letsfindaway/basement-ventilation/doc/feather.jpg

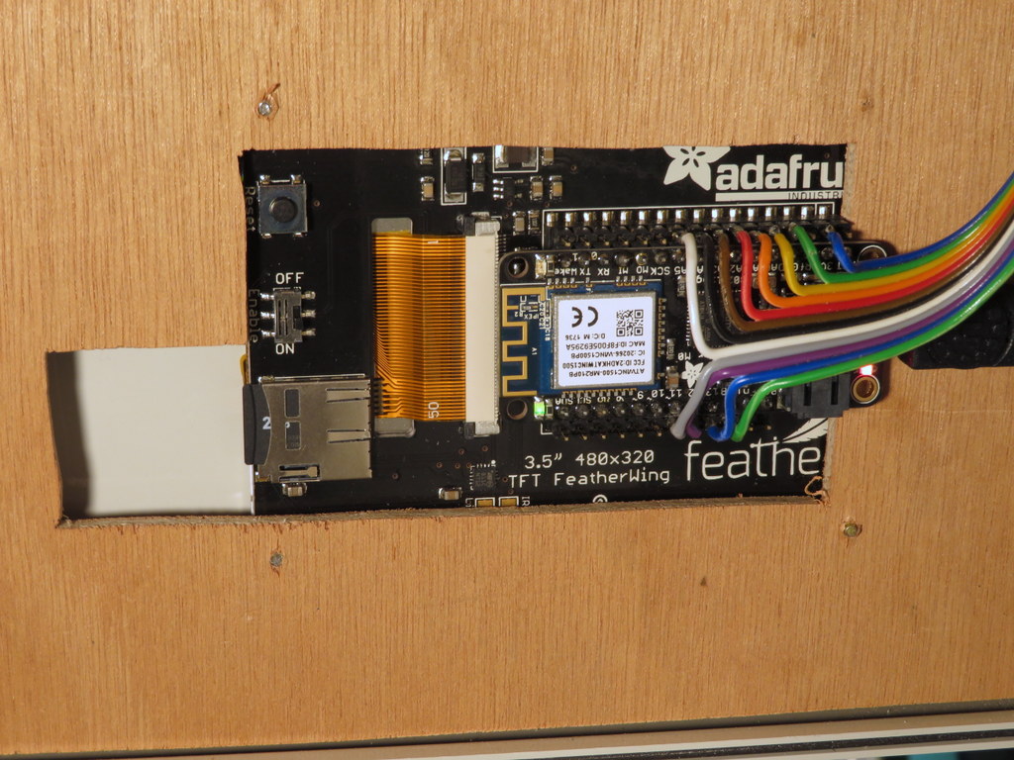
doc/feather.jpg
