letsfindaway/basement-ventilation/sdcard/Screen1.bmp

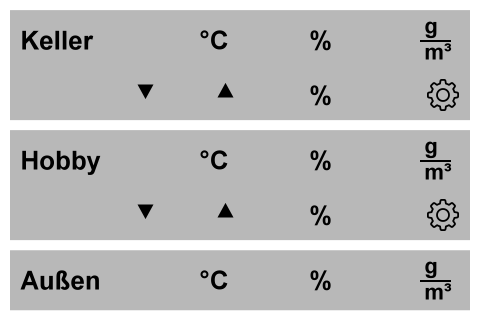
sdcard/Screen1.bmp
