letsfindaway/basement-ventilation/(threads)

Thread 2 (2018-01-24):

Switch display backlight off for power saving

letsfindaway, 2018-01-24:
Most probably the display backlight is the biggest power consumer of the system.

For power saving we might consider to switch the display backlight off after e.g. 3 minutes of inactivity on the touch screen. We will switch it on again on the first touch detected.

letsfindaway, 2018-02-02:
Switching the backlight can be acomplished by using GPIO2 of the touch controller. This can be accessed using the low level interface routines of the controller.

Initialization:
```c++
// define both GPIO2 and GPIO3 as outputs
TS.writeRegister8(SPME_GPIO_DIR, 0x0c);
// initially switch on the backlight
TS.writeRegister8(SPME_GPIO_SET_PIN, 0x04);
```

Switch on and off:
```c++
// switch on the backlight
TS.writeRegister8(SPME_GPIO_SET_PIN, 0x04);
// switch off the backlight
TS.writeRegister8(SPME_GPIO_CLR_PIN, 0x04);
```

Thread 3 (2018-01-24):

Graphical display of data on display and/or remotely

letsfindaway, 2018-01-24:
A nice feature would be to display the absolute humidity and window mode or other data graphically either on the TFT display or remotely on a browser. Most interesting is data from the same day or yesterday.

For local display we have to  develop a user interaction scheme: how to switch to the graphical display and back, how to select the date. We will then read the corresponding CSV file and evaluate and display the data.

For remote display, the URL scheme needs to be defined. Similar the CSV files will be read and a SVG graphic is generated from that.

Both will work quite similar, so a common concept would be useful.

letsfindaway, 2018-01-26:
This would also be the right time to extract writing the CSV data to the SD card and extracting information from there to a common class. Currently this is scattered over `Anzeige` and `Wlan`.

letsfindaway, 2018-01-27:
Some more ideas on this feature and its implementation:

Features:

* daily and weekly graphs of absolute humidity in the two rooms and outside
* thin line while window is closed, thicker line when opened
* x-axis with marks and labeling
  * daily diagram: ticks every hour, label every 3 hours
  * weekly diagram: ticks every 6 hours, label every 12 hours
* y-axis with horizontal lines and label
  * automatically scaled for the biggest value, rounded to the next higher integer
  * ticks every 1, labels every 1, 2 or 5 ticks, so that no more than 8 labels are necessary
* navigation to the next/previous day/week
* output to the TFT display or as SVG for the browser

Implementation notes:

* The diagram class uses an abstract class for drawing which can draw rectangles, lines, text and triangles with a link.
* there are two implementations of this class, one writing to the TFT display and one for SVG writing to a `Print*`
* links are mapped to hotspots for the touch screen or hypertext links for SVG.
* The CSV parser necessary to gather the data will write it to an optimized data structure using 2 bytes to represent the value and window mode. This will result in a maximum of 3 (lines) * 24 (hours) * 12 (values/hour) * 2 bytes = 1728 data bytes. Our Feather M0 can cope with this.

Thread 5 (2018-01-26):

More documentation about setup, assembly, etc

letsfindaway, 2018-01-26:
Add some more information about the housing, how I wired everything and so on as suggestion for others.

Thread 6 (2018-01-26):

Use WiFi.getTime() instead of own NTP requests

letsfindaway, 2018-01-26:
I just discovered that WiFi already has a `getTime` method returnng a time which is automatically fetched by the WiFi module from an NTP server. See https://www.arduino.cc/en/Reference/WiFi101GetTime. So I could just replace my NTP stuff by a call to this method.

letsfindaway, 2018-01-28:
May be this can be implemented very easy using the TimeLib's `setSyncProvider` function.

Thread 8 (2018-02-04):

Spurious 500 response when requesting overview via browser

letsfindaway, 2018-02-04:
When requesting the SVG overview image via browser I sometimes get a 500 error response, which is produces when the simple web server cannot interpret the header.

Investigate why this is the case and how to avoid it.

Thread 11 (2018-03-19):

Make threshold for motor current configurable

letsfindaway, 2018-03-19:
Currently the threshold value for detection of motor current is a fixed constant inside the source code. This should be more flexible and probably made configurable, at least extracted to `customize.h`

letsfindaway, 2018-04-19:
closed with commit 159bacd7daed1971bcfd2673f2f67fde863fdc37

Closed 2018-04-19.

Thread 13 (2018-04-02):

Implement overcurrent protection for motors

letsfindaway, 2018-04-02:
As we are already monitoring the actuator motor current to detect the end position, this measurement could also be used to implement an overcurrent protection to switch off the motors when e.g. a window is blocked.

The threshold should be configurable via the `customize.h` header file.

letsfindaway, 2018-04-05:
Desired behavior:

* when current over limit set motor to blocked and room mode to alarm
* indicate room mode by icon
* to remove alarm, touch icon, this sets mode to manual and motor to stop
* up/down arrows cannot remove alarm

Closed 2018-04-16.

Thread 14 (2018-04-02):

Use reed switch impulses for actuator position detection

letsfindaway, 2018-04-02:
Instead of measuring the time we should use the reed contacts of the actuators to determine the position. This should also be used to avoid that the end switches of the actuators are activated in normal operation, as these switches are not designed for continuous operation but merely serve as an emergency shutoff.

letsfindaway, 2023-04-04:
Dropped after moving to Comunello AIRWIN actuators, which do not have a position indicator.

Thread 15 (2022-12-23):

Adapt to Comunello AirWin window motor

letsfindaway, 2022-12-23:
As the DARL 3610 actuators now failed for the second time, I invest a little bit more money and bought Comunello AirWin actuators. I also had to replace the 36V power supply by a 24V version.

As the AirWin actuators have a slow start feature, the current detection values have to be adapted.

letsfindaway, 2022-12-26:
The following things have to be adapted:

- When starting, the motor draws a high startup current for a few milliseconds. We have to ignore this initial peak.
- After that, the slow-start feature of the motor draws a low current for about 2 seconds, before reaching the normal operation level.
- When the window is fully open or fully closed, the motor operates against an obstacle and the current increases. If we want to stop, before the internal obstacle detection triggers, we have to stop the motor when we detect this increase.
- When the internal obstacle detection is triggered, the current drops to a very low value of a few milliampere.

Note: as the motor has a nominal force of up to 450N, the internal obstacle detection triggers at an even higher value. For me this was too high, so I have to stop the motors earlier.

letsfindaway, 2023-04-01:
The changes are now complete in code and documentation and merged to `master`.

Closed 2023-04-01.
