letsfindaway/basement-ventilation/basement-ventilation/motor.cpp

/*
 * Copyright (c) letsfindaway. All rights reserved.
 * Licensed under the MIT License. See LICENSE file in the project root for full license information.
 */

#include "motor.h"
#include "customize.h"
#include "settings.h"
#include "logger.h"

#include <Arduino.h>

#define ZU_MS    -10000
#define AUF_MS    60000
#define KALIB_MS 999999

Motor::Motor(Ort ort)
  : ort(ort), richtung(STOP), status(STOP)
{
  lastpos = -1;
  fullms = 20000;
  posms = fullms;
}

/**
 * @brief Motor::moveto
 *
 * Move motor to given position.
 * This method only sets zielms but does not change the state of the object otherwise.
 * Selection and assignment of motor is performed in update().
 * The state machine is executed in move().
 *
 * @param pos Position (0 .. 100)
 */
void Motor::moveto(int pos)
{
  if (pos == lastpos) {
    return;
  }

  lastpos = pos;

  Log.print("Motor ");
  Log.print(ort);
  Log.print(" moveto(");
  Log.print(pos);
  Log.print(") Previous target=");
  Log.print(zielms);

  fullms = Settings::settings.getFullMs(ort);
  long z = fullms * pos / 100;

  // for end position define a target far beyond end so that end switches are safely reached
  if (z == 0) {
    z = ZU_MS;
  } else if (z == fullms) {
    z = AUF_MS;
  }

  if (z != zielms) {
    Log.print(" New target=");
    Log.print(z);
    zielms = z;
  }

  Log.println();
}


/**
 * @brief Motor::update
 *
 * Determine direction from actual position and target position.
 * This method only modifies richtung and does not change the state of the object otherwise.
 * richung is used as event for the state machine in move().
 *
 * @return true when motor shall be moved
 */
bool Motor::update()
{
  if (posms < zielms - 300) {
    // open
    richtung = AUF;

    if (!moving && status != BLOCK) {
      Log.println("Start motor OPEN");
      moving = this;
    }

    return true;
  } else if (posms > zielms + 300) {
    // close
    richtung = ZU;

    if (!moving && status != BLOCK) {
      Log.println("Start motor CLOSE");
      moving = this;
    }

    return true;
  } else {
    richtung = STOP;
    return false;
  }
}

/**
 * @brief Motor::kalibrieren
 *
 * Calibrate motor by determining the time it takes to open the window completely.
 * This information is used to translate a percentage into a operation time.
 */
void Motor::kalibrieren()
{
  /*
   * First close completely, then open completely and count milliseconds
   * When current drops, then end switch must have been reached
   */
  posms = KALIB_MS;
  zielms = 0;
  starttime = millis();

  do {
    update();
    delay(10);
  } while (move());

  posms = 0;
  fullms = KALIB_MS;
  zielms = KALIB_MS;

  do {
    update();
    delay(10);
  } while (move());

  fullms = posms;
  Log.print("fullms=");
  Log.println(fullms);
  Settings::settings.setFullMs(ort, fullms);
}


int Motor::pos()
{
  // begrenze posms
  if (posms < 0) {
    posms = 0;
  } else if (posms > fullms) {
    posms = fullms;
  }

  return map(posms, 0, fullms, 0, 100);
}

bool Motor::blocked(bool keep)
{
  bool block = status == BLOCK;

  if (block && !keep) {
    status = STOP;
    Log.println("Unblocked, status=STOP");
  }

  return block;
}

/**
 * @brief Motor::move
 *
 * Motor state machine
 *
 * @return true when a motor is moving
 */
bool Motor::move()
{
  static int cnt = 0;

  if (moving) {
    /*
     * Current supervision for AirWin
     *
     * The motor may have a high initial current during some few milliseconds.
     *   - ignore high current for BV_MOTOR_STARTUP_TIME
     * The motor may have low current for some ramp up time
     *  - ignore low current for BV_MOTOR_RAMP_TIME
     * Current increases when window is fully open or closed
     *  - use high current as indicator for end position
     * Current drops when internal obstacle detection is activated
     *  - use low current as indicator for end position
     */
    int curr = analogRead(MOTOR_STROM);
    unsigned long time = millis() - moving->starttime;
    bool motorOn = moving->status == AUF || moving->status == ZU;
    bool lowCurrent = time > BV_MOTOR_RAMP_TIME && curr < BV_CURRENT_LOW;
    bool highCurrent = time > BV_MOTOR_STARTUP_TIME && curr > BV_CURRENT_HIGH;

    if (motorOn && (lowCurrent || highCurrent)) {
      Log.print("Limit reached, current=");
      Log.print(BV_MILLIAMP(curr));
      Log.println(" mA");

      // overcurrent, set emergency mode and inhibit further movement
      // Emergency mode not needed with AirWin actuators
      /* if (curr > BV_CURRENT_HIGH) {
        Log.print("Overcurrent, blocked! ");
        Log.println(BV_MILLIAMP(curr));
        moving->status = BLOCK;
      } else */ 
      
      if (moving->fullms != KALIB_MS) {
        // restore calibration
        moving->posms = moving->status == ZU ? 0 : moving->fullms;
      }

      moving->zielms = moving->posms;
      moving->richtung = STOP;
    }
    
    if (++cnt % 10 == 0) {
      Log.print("Motorstrom ");
      Log.print(BV_MILLIAMP(curr));
      Log.println(" mA");
    }

    switch (moving->status) {
    case STOP:
      digitalWrite(FENSTER_HOBBY, RELAY_OFF);
      digitalWrite(FENSTER_AUF, RELAY_OFF);
      digitalWrite(FENSTER_ZU, RELAY_OFF);
      digitalWrite(MOTOR_AN, RELAY_OFF);

      if (moving->richtung == AUF) {
        Log.println("Motor status TRANS_AUF");
        moving->status = TRANS_AUF;
        moving->starttime = millis();
      } else if (moving->richtung == ZU) {
        Log.println("Motor status TRANS_ZU");
        moving->status = TRANS_ZU;
        moving->starttime = millis();
      } else {
        Log.println("Motor STOP");
        moving = nullptr;
      }
      break;

    case TRANS_AUF:
      digitalWrite(FENSTER_HOBBY, moving->ort == HOBBY ? RELAY_ON : RELAY_OFF);
      digitalWrite(FENSTER_AUF, RELAY_ON);
      digitalWrite(FENSTER_ZU, RELAY_OFF);
      digitalWrite(MOTOR_AN, RELAY_OFF);

      if (moving->richtung == AUF) {
        if (millis() - moving->starttime > 500) {
          Log.println("Motor status AUF");
          moving->status = AUF;
          moving->startms = moving->posms;
          moving->starttime = millis();
        }
      } else if (moving->richtung == ZU) {
        if (millis() - moving->starttime > 500) {
          Log.println("Motor status TRANS_ZU");
          moving->status = TRANS_ZU;
          moving->starttime = millis();
        }
      } else {
        if (millis() - moving->starttime > 500) {
          Log.println("Motor status STOP");
          moving->status = STOP;
        }
      }
      break;

    case AUF:
      digitalWrite(FENSTER_HOBBY, moving->ort == HOBBY ? RELAY_ON : RELAY_OFF);
      digitalWrite(FENSTER_AUF, RELAY_ON);
      digitalWrite(FENSTER_ZU, RELAY_OFF);
      digitalWrite(MOTOR_AN, RELAY_ON);

      if (moving->richtung == AUF) {
        moving->posms = moving->startms + (millis() - moving->starttime);
      } else {
        Log.println("Motor status TRANS_AUF");
        moving->status = TRANS_AUF;
        moving->starttime = millis();
      }
      break;

    case TRANS_ZU:
      digitalWrite(FENSTER_HOBBY, moving->ort == HOBBY ? RELAY_ON : RELAY_OFF);
      digitalWrite(FENSTER_AUF, RELAY_OFF);
      digitalWrite(FENSTER_ZU, RELAY_ON);
      digitalWrite(MOTOR_AN, RELAY_OFF);

      if (moving->richtung == AUF) {
        if (millis() - moving->starttime > 500) {
          Log.println("Motor status TRANS_AUF");
          moving->status = TRANS_AUF;
          moving->starttime = millis();
        }
      } else if (moving->richtung == ZU) {
        if (millis() - moving->starttime > 500) {
          Log.println("Motor status ZU");
          moving->status = ZU;
          moving->startms = moving->posms;
          moving->starttime = millis();
        }
      } else {
        if (millis() - moving->starttime > 500) {
          Log.println("Motor Status STOP");
          moving->status = STOP;
        }
      }
      break;

    case ZU:
      digitalWrite(FENSTER_HOBBY, moving->ort == HOBBY ? RELAY_ON : RELAY_OFF);
      digitalWrite(FENSTER_AUF, RELAY_OFF);
      digitalWrite(FENSTER_ZU, RELAY_ON);
      digitalWrite(MOTOR_AN, RELAY_ON);

      if (moving->richtung == ZU) {
        moving->posms = moving->startms - (millis() - moving->starttime);
      } else {
        Log.println("Motor status TRANS_ZU");
        moving->status = TRANS_ZU;
        moving->starttime = millis();
      }
      break;

    case BLOCK:
      digitalWrite(MOTOR_AN, RELAY_OFF);
      Log.println("Stop motor, blocked");
      moving = nullptr;
      break;
    }
  } else {
    digitalWrite(FENSTER_HOBBY, RELAY_OFF);
    digitalWrite(FENSTER_AUF, RELAY_OFF);
    digitalWrite(FENSTER_ZU, RELAY_OFF);
    digitalWrite(MOTOR_AN, RELAY_OFF);
  }

  return moving;
}


Motor* Motor::moving = nullptr;


const char *Motor::toString(Richtung r)
{
  static const char* rtext [] = {
    "STOP",
    "AUF",
    "ZU",
    "TRANS_AUF",
    "TRANS_ZU",
    "BLOCK"
  };

  return rtext[r];
}
