letsfindaway/basement-ventilation/basement-ventilation/enums.h

#ifndef ENUMS_H
#define ENUMS_H

enum Ort {
  KELLER,
  HOBBY,
  AUSSEN
};

enum Modus {
  MANUELL,
  AUTOMATISCH,
  FEUCHT,
  TROCKEN,
  HEIZUNG,
  TEMPERATUR,
  ALARM
};

enum Richtung {
  STOP,
  AUF,
  ZU,
  TRANS_AUF,
  TRANS_ZU,
  BLOCK
};

#endif // ENUMS_H
