letsfindaway/basement-ventilation/basement-ventilation/klima.h

/*
 * Copyright (c) letsfindaway. All rights reserved.
 * Licensed under the MIT License. See LICENSE file in the project root for full license information.
 */

#ifndef KLIMA_H
#define KLIMA_H

#include "enums.h"

#include <DHT.h>
#include <DHT_U.h>
#include <Adafruit_Sensor.h>

/**
 * @brief The Klima class manages a DHT22 sensor, reads it in configurable
 * intervals and computes the absolute humidity out of the temperature and
 * relative humidity readings.
 */
class Klima {
  public:
    Klima(Ort ort, int pin);
    void setup(unsigned long when, unsigned long every);
    bool update();

  private:
    Ort ort;
    DHT dht;
    long next;
    long every;

  public:
    float temp;
    float humidity;
    float abshum;
};

#endif
