letsfindaway/basement-ventilation/(commit log)

2018-01-20 added motor.md and some images
2018-01-20 replace Time.h by TimeLib.h in #include
    [anzeige.cpp]
2018-01-24 added copyright headers added delay during SPI device switchover (improved stability) added code.md (still incomplete)
    [anzeige.cpp, anzeige.h, basement-ventilation.ino, klima.cpp, klima.h, logger.cpp, logger.h, motor.cpp]
2018-01-26 corrected motorstatemachine
2018-01-26 added spi.md
2018-01-27 extracted many customizable values to customize.h extracted commonly used enums to enums.h
    Fixes #1
    [anzeige.cpp, anzeige.h, basement-ventilation.ino, customize.h, enums.h, klima.h, logger.cpp, motor.cpp]
2018-01-28 added draw.io source files for diagrams
    [motorstatemachine.xml]
2018-02-23 add error handling in logger and reinitialize socket on any failure
    hopefully Fixes #9
    [logger.cpp, logger.h]
2018-04-07 add overcurrent protection
    Fixes #13
    [basement-ventilation.ino, customize.h, enums.h, motor.cpp, motor.h, raum.cpp, wlan.cpp]
2018-04-16 Implement feature 13 Overcurrent detection
    added exclamation mark icon for alarm status indication
    added Raum.setModus to avoid direct access to member variable and to handle reset of alarm status
    adapted low current in customize.h
    added overcurrent handling in Motor
    added alarm mode in Raum
    Closes #13
    [anzeige.cpp, basement-ventilation.ino, customize.h, motor.cpp, raum.cpp, raum.h]
2018-04-22 typo in spi.md
2022-12-26 adapt to AirWin window motors
    - initial current, ramp-up and end detection
2023-04-01 doc: update to Comunello AirWin motor
